davideochoa/kaablab/thesis/preliminares/12-resumen.md

# RESUMEN

El proyecto KaabLab busca adaptar, reentrenar y validar en condiciones reales un sistema de monitoreo inteligente de colmenas de *Melipona beecheii* basado en el Internet de las Cosas (IoT) e Inteligencia Artificial (IA). El pipeline de referencia (Chin-Canché et al., 2026a, 2026b) fue validado sobre datos de *Apis mellifera* en California y no ha sido adaptado a esta especie ni al clima tropical de Campeche; su módulo de visión computacional para detección de *Varroa destructor* no es transferible, pues Varroa no parasita a *Melipona beecheii*, y se excluye.

El sistema integra un módulo de análisis bioacústico —basado en Coeficientes Cepstrales en Escala de Frecuencias Mel (MFCC), vibración estructural y variables ambientales— y un módulo de conteo infrarrojo de tráfico en la piquera como proxy del forrajeo. Como contribución de diseño original se incorpora una arquitectura sensorial heterogénea con rangos complementarios: dos sensores de temperatura y humedad (interno primario y externo secundario), un micrófono para nivel acústico y estado general de la colonia, un acelerómetro para vibración del nido y un sensor infrarrojo de doble haz para conteo direccional. Esta arquitectura elimina modos de falla comunes, cubre la alta humedad relativa (>85% HR) donde el sensor externo se degrada, habilita el contraste diagnóstico interno-externo propio de una especie termoconformadora y captura las vibraciones estructurales mediante las cuales otros meliponinos expresan comportamiento defensivo (no documentado en *Melipona beecheii*), no registrables directamente con un micrófono (vibración de sustrato).

Esta tesis cierra tres brechas del trabajo previo: ausencia de datos propios de *Melipona beecheii*, falta de regionalización al clima tropical y ausencia de preprocesamiento de señal documentado antes de la extracción de características. Construye el primer dataset multimodal documentado de la especie y caracteriza cinco brechas bibliográficas en sus parámetros de medición (sección 1.1.5).

**Palabras clave: **meliponicultura maya, *Melipona beecheii*, monitoreo inteligente de colmenas, arquitectura sensorial heterogénea, redundancia sensorial, preprocesamiento de señal, fusión sensorial ponderada, bioacústica, vibración estructural, conteo infrarrojo de tráfico, IoT, XGBoost.
