davideochoa/kaablab/thesis/referencias.md

# Referencias

Formato APA. Este archivo es la fuente de trabajo versionada; la conversión a `.bib` (BibTeX) para gestión de citas queda pendiente (ver `docs/REVISION_2026-09.md`).

Chin-Canché, G. A. (2026). *GuillermoChin/kaablab-bee-congress-2026-figures: KAABLAB Bee Congress 2025: Figure reproduction package* (Versión v1.0.0) [Software]. Zenodo. https://doi.org/10.5281/zenodo.19685877

Chin-Canché, G. A., Ruíz-Canul, K., Grajales-Rodríguez, A. A., Guerrero-Mota, R. A., Noh-Valdéz, J. A., & Euan-Cupul, F. I. (2026a). KAABLAB: Sistema AIoT para el monitoreo y detección temprana de anomalías en colonias de abejas [Manuscrito inédito]. Instituto Tecnológico Superior de Calkiní.

Chin-Canché, G. A., Ruíz-Canul, K., Grajales-Rodríguez, A. A., Guerrero-Mota, R. A., Noh-Valdéz, J. A., & Euan-Cupul, F. I. (2026b). Kaablab: Sistema AIOT para el monitoreo y detección temprana de anomalías en colonias de *Apis mellifera*. En II Congreso sobre Abejas, Biodiversidad y Soberanía Alimentaria. *Ciencia y Tecnología ITESCAM-Calkiní, 5*(S4), 20. ISSN 2992-7692.

Cruz-López, L., Malo, E. A., Rojas, J. C., & Morgan, E. D. (2005). Chemical composition and stimulatory olfactory response of the mandibular gland secretion in *Melipona beecheii*. *Journal of Chemical Ecology, 31*(6), 1257-1268.

dos Santos, F. J., Bomfim, I. G. A., Cavalcante, M. C., Coelho, A. A. da P., & Gomes, D. G. (2025). Intranidal vibrational sensing mechanisms in stingless bees: an exploratory study. *Engenharia Agrícola, 45*(especial 2, ConBAP 2024), e20250069. https://doi.org/10.1590/1809-4430-Eng.Agric.v45nespe220250069/2025

Hrncir, M., Jarau, S., Zucchi, R., & Barth, F. G. (2000). Recruitment behavior in stingless bees, *Melipona scutellaris* and *M. quadrifasciata*. II. Possible mechanisms of communication. *Apidologie, 31*(1), 93–113. https://doi.org/10.1051/apido:2000109

Hrncir, M., Barth, F. G., & Tautz, J. (2006). Vibratory and airborne-sound signals in bee communication (Hymenoptera). In S. Drosopoulos & M. F. Claridge (Eds.), *Insect sounds and communication: Physiology, behaviour, ecology and evolution* (pp. 421–436). CRC Press.

Hrncir, M., Gravel, A.-I., Schorkopf, D. L. P., Schmidt, V. M., Zucchi, R., & Barth, F. G. (2008). Thoracic vibrations in stingless bees (*Melipona seminigra*): Resonances of the thorax influence vibrations associated with flight but not those associated with sound production. *Journal of Experimental Biology, 211*(5), 678–685. https://doi.org/10.1242/jeb.013920

Justino, A. R., & Hartfelder, K. (2024). A versatile recording device for the analysis of continuous daily external activity in colonies of highly eusocial bees. *Journal of Comparative Physiology A, 210*(6), 885-900. https://doi.org/10.1007/s00359-024-01709-2

Macías-Macías, J. O., Quezada-Euán, J. J. G., Contreras-Escareño, F., Tapia-González, J. M., Moo-Valle, H., & Ayala, R. (2011). Comparative temperature tolerance in stingless bee species from tropical highlands and lowlands of Mexico and implications for their conservation (Hymenoptera: Apidae: Meliponini). *Apidologie, 42*, 679–689. https://doi.org/10.1007/s13592-011-0074-0

Medina-Medina, L. A., Hart, A. G., & Ratnieks, F. L. W. (2014). Waste management in the stingless bee *Melipona beecheii* Bennett (Hymenoptera: Apidae). *Sociobiology, 61*(4), 435-440. https://doi.org/10.13102/sociobiology.v61i4.435-440

Moo-Valle, H., Quezada-Euán, J. J. G., Navarro, J., & Rodríguez-Carvajal, L. A. (2000). Patterns of intranidal temperature fluctuation for *Melipona beecheii* colonies in natural nesting cavities. *Journal of Apicultural Research, 39*, 3–7.

Pat Fernández, L. A., Anguebes Franceschi, F., Pat Fernández, J. M., Hernández Bahena, P., & Ramos Reyes, R. (2018). Condición y perspectivas de la meliponicultura en comunidades mayas de la reserva de la biósfera Los Petenes, Campeche, México. *Estudios de Cultura Maya, 52*, 227-254. https://doi.org/10.19130/iifl.ecm.2018.52.939

Quezada-Euán, J. J. G. (2018). *Stingless Bees of Mexico: The Biology, Management and Conservation of an Ancient Heritage*. Springer.

Roubik, D. W. (2006). Stingless bee nesting biology. *Apidologie, 37*(2), 124–143. https://doi.org/10.1051/apido:2006026

Roubik, D. W., & Peralta, F. J. A. (1983). Thermodynamics in nests of two *Melipona* species in Brazil. *Acta Amazonica, 13*, 453–466.

Schurischuster, S., & Kampel, M. (2020). *VarroaDataset* [Data set]. Zenodo. https://doi.org/10.5281/zenodo.4085044

Suárez Carvajal, Y. Y. (2025). Estimación del impacto de variables internas y ambientales en la vitalidad de las colonias de Melipona eburnea en Colombia, generando alertas tempranas que permitan optimizar el manejo y mejorar su bienestar [Trabajo de grado de maestría, Universidad Tecnológica de Pereira]. Facultad de Ingeniería Mecánica, Pereira, Colombia.

Yang, A. (2022). *Beehive sounds* [Data set]. Kaggle. https://kaggle.com/datasets/annajyang/beehive-sounds

## Referencias ya citadas en el cuerpo de la tesis (no verificadas en esta revisión)

Las siguientes referencias ya son citadas en los capítulos existentes pero no fueron parte del alcance de esta revisión (PASO 7); se listan aquí para que la compilación final de la bibliografía las incluya:

- Cauich Kumul, R., Ruiz Ruiz, J. C., Ortíz Vázquez, E., & Segura Campos, M. R. (2015). Potencial antioxidante de la miel de *Melipona beecheii* y su relación con la salud: una revisión. *Nutrición Hospitalaria, 32*(4), 1432–1442. https://doi.org/10.3305/nh.2015.32.4.9312
- Ramírez-Miranda, I., Moguel-Ordóñez, Y., Acevedo-Fernández, J. J., & Betancur-Ancona, D. (2023). Calidad microbiológica y actividad antibacteriana de miel producida por Melipona beecheii en Yucatán, México. *Revista MVZ Córdoba, 28*(2), e3175. https://doi.org/10.21897/rmvz.3175
- Uthoff, C., Homsi, M. N., & von Bergen, M. (2023). Acoustic and vibration monitoring of honeybee colonies for beekeeping-relevant aspects of presence of queen bee and swarming. *Computers and Electronics in Agriculture, 205*, 107589. https://doi.org/10.1016/j.compag.2022.107589
- Villanueva-Gutiérrez, R., Roubik, D. W., Colli-Ucán, W., Güemez-Ricalde, F. J., & Buchmann, S. L. (2013). A critical view of colony losses in managed Mayan honey-making bees (Apidae: Meliponini) in the heart of Zona Maya. *Journal of the Kansas Entomological Society, 86*(4), 352–362. https://doi.org/10.2317/JKES130131.1
