davideochoa/kaablab/thesis/docs/FORMATO_TESIS.md

# Formato oficial de tesis — ITESCAM (Maestría en Ciencias de la Ingeniería / Inteligencia Artificial)

Fuente: Estructura_de_tesis_de_posgrado_Revisada.docx (plantilla institucional).

## Página

- Tamaño: carta (letter).
- Márgenes: 2.5 cm en los cuatro lados.
- Numeración de página: pie de página, alineada a la derecha, Arial 11 pt.
- Preliminares (desde el índice hasta la página anterior al resumen): numeración romana minúscula (i, ii, iii...).
- Cuerpo (desde la Introducción en adelante): numeración arábiga, iniciando en 1.

## Tipografía

- Cuerpo de texto: Arial 11 pt, interlineado 1.5, espaciado de párrafo: 12 pt antes / 0 pt después.
- Títulos de capítulo: Arial 12 pt, MAYÚSCULAS, negritas, alineados a la IZQUIERDA. Numeración con romanos (I, II, III, IV, V).
- Subtítulos de nivel 1 (dentro de un capítulo): Arial 11 pt, MAYÚSCULAS, negritas.
- Subtítulos de nivel 2 en adelante: Arial 11 pt, Mayúsculas y minúsculas, negritas.
- Secciones especiales del preliminar (RESUMEN, ABSTRACT, INTRODUCCIÓN, etc.): MAYÚSCULAS, negritas, CENTRADAS (distinto de los títulos de capítulo, que van a la izquierda).

## Estructura de capítulos (confirmada con el usuario)

- Capítulo I: Antecedentes, justificación, hipótesis, objetivos generales y específicos, y estrategia experimental (incluye el estado del arte / marco teórico, fusionado aquí, no como capítulo separado).
- Capítulo II: Materiales y Métodos.
- Capítulo III: Resultados y Discusiones.
- Capítulo IV: Recomendaciones.
- Capítulo V: Conclusiones.

Nota: la plantilla original omite por error la línea del Capítulo IV (salta de "Capítulo III" a "Capítulo V"); la estructura de 5 capítulos arriba fue confirmada explícitamente con el autor de la tesis como la interpretación correcta.

## Orden del cuerpo antes de la Introducción

1. Portada interior
2. Carta de liberación de tesis (CPI-FO-05-06)
3. Oficio de autorización del comité tutorial/claustro doctoral
4. Carta de reconocimiento del director(a) y codirector(a)
5. Declaración de propiedad intelectual
6. Carta de cesión de derechos (requerida por los Lineamientos TecNM 2023, 3.9; no aparece en la plantilla institucional; incluir con firma autógrafa)
7. Oficio de liberación (análisis anti-plagio)
8. Agradecimientos (si aplica beca)
9. Índice completo
10. Listado de abreviaturas (si aplica)
11. Índice de Figuras (solo títulos)
12. Índice de Tablas (solo títulos)
13. Resumen (español) — máximo 1 cuartilla
14. Abstract (inglés) — máximo 1 cuartilla
15. Introducción — máximo 2 cuartillas

## Tablas y figuras

- Formato: "Tabla 1.1" / "Figura 1.1" en negritas, SIN punto después del número, numeración correlativa por capítulo (el primer número es el del capítulo).
- Fuente: Arial 10 pt, mayúsculas y minúsculas.
- El pie de figura/tabla va en el renglón inmediato siguiente a la figura/tabla.
- Tamaño: no debe rebasar los márgenes del texto.

## Citas y bibliografía (formato APA)

- Un autor: (Apellido, Año).
- Dos autores: (Apellido1 y Apellido2, Año).
- Más de dos autores: (Apellido et al., Año).
- Múltiples citas en un mismo paréntesis: ordenar de la más reciente a la más antigua, separadas por punto y coma. Ejemplo: (López y Pérez, 2010; Smith, 2009; Wilmer et al., 1998).
- Listado bibliográfico: orden alfabético y cronológico, sangría francesa de 1.5 cm, interlineado 1.5, espaciado 12 pt antes / 0 pt después, formato APA.
- Se incluyen todas las referencias de todos los capítulos en una sola bibliografía al final.

## Nombre científico de la especie (PROVISIONAL — pendiente de confirmar con asesor)

El asesor indicó que el nombre científico de la especie lleva un formato especial, pero la recomendación exacta no quedó registrada. Mientras se confirma, se aplica la convención taxonómica estándar:

- Nombre científico completo (género + especie) siempre en cursivas: *Melipona beecheii*.
- Primera mención en cada capítulo: nombre completo con autor taxonómico — *Melipona beecheii* Bennett, 1831.
- Menciones subsecuentes en el mismo capítulo: género abreviado, en cursivas — *M. beecheii*.
- Nunca abreviar en: primera mención de una sección nueva, títulos de tabla/figura, resumen o abstract.

## Pendiente de verificar con el asesor

- Confirmar si la fusión del Estado del Arte dentro del Capítulo I (en vez de capítulo separado) es aceptable, dado que este proyecto tiene suficiente revisión de literatura propia para justificar un capítulo dedicado.
- Confirmar el formato exacto solicitado por el asesor para el nombre científico de la especie (la convención de arriba es una suposición de trabajo, no la recomendación real).
