davideochoa/kaablab/thesis/preliminares/00-portada.md

**INSTITUTO TECNOLÓGICO SUPERIOR DE CALKINÍ**

**SUBDIRECCIÓN ACADÉMICA DE INVESTIGACIÓN E INNOVACIÓN**

**MAESTRÍA EN INTELIGENCIA ARTIFICIAL**

**KAABLAB: INNOVACIÓN PARA LA PROTECCIÓN DE LAS ABEJAS MAYAS MEDIANTE UN SISTEMA INTELIGENTE DE MONITOREO DE COLMENAS DE MELIPONA BEECHEII BASADO EN IoT E INTELIGENCIA ARTIFICIAL**

**TESIS**

Que para obtener el título de:

**MAESTRO EN INTELIGENCIA ARTIFICIAL**

Presenta:

**DAVID ENRIQUE OCHOA DIAZ**

Comité tutorial:

Director: Dra. Marlene Méndez Moreno

Codirector: Dr. Rogelio Alfredo Flores Haas

Asesor interno: Mtro. Daniel Bolivar Moreno

Asesor externo: Dr. Henry Jesus Loeza Concha - Colegio de Posgraduado Campeche

Calkiní, Campeche, México — 2026
