davideochoa/kaablab/thesis/preliminares/04-declaracion-propiedad-intelectual.md

# DECLARACIÓN DE PROPIEDAD INTELECTUAL

Yo, David Enrique Ochoa Diaz, estudiante del programa de Maestría en Inteligencia Artificial del Instituto Tecnológico Superior de Calkiní en el Estado de Campeche (ITESCAM), del Tecnológico Nacional de México (TecNM), declaro que la tesis titulada “KAABLAB: INNOVACIÓN PARA LA PROTECCIÓN DE LAS ABEJAS MAYAS MEDIANTE UN SISTEMA INTELIGENTE DE MONITOREO DE COLMENAS DE *MELIPONA BEECHEII* BASADO EN IoT E INTELIGENCIA ARTIFICIAL” es una obra original, resultado de mi trabajo de investigación, desarrollada bajo la dirección de la Dra. Marlene Méndez Moreno.

Declaro que:

1. Las fuentes, ideas, datos, figuras y resultados de terceros utilizados están debidamente citados y referenciados.
2. El trabajo no ha sido presentado total ni parcialmente para obtener otro grado académico en esta u otra institución.
3. Los datos experimentales, el código fuente y los resultados fueron generados por mí en el marco del proyecto KaabLab y son fieles a los obtenidos durante la investigación.
4. La protección de la propiedad intelectual (derechos de autor y propiedad industrial) se sujeta a la Ley de Ciencia y Tecnología, a la normativa aplicable vigente, a los Lineamientos para la Operación de los Estudios de Posgrado del TecNM (2023) y a las directrices de la Secretaría de Extensión y Vinculación del TecNM. Los trámites de propiedad industrial (patentes, modelos de utilidad, diseños industriales) corresponden al IMPI y los de derechos de autor, al INDAUTOR.
5. Los artículos, libros o memorias derivados de este trabajo se regirán por el apartado 6.1 de los Lineamientos: si los publica una editorial comercial, los derechos se ceden a ésta; si los publica el TecNM, la titularidad corresponde en su totalidad al TecNM.
6. Autorizo el depósito de la tesis en el repositorio institucional de acceso abierto, en los términos de la Ley Federal del Derecho de Autor, salvo que exista acuerdo de confidencialidad o proceso de registro de propiedad intelectual en curso. Condición de acceso:

   ☐ Sin restricción ☐ Restringido por confidencialidad o registro de propiedad intelectual

7. Asumo la responsabilidad por cualquier reclamación de terceros derivada de la violación de derechos de propiedad intelectual relacionada con este trabajo.

Calkiní, Campeche, a 16 de octubre de 2026

David Enrique Ochoa Diaz

10383
