davideochoa/kaablab/thesis/preliminares/05-carta-cesion-derechos.md

# CARTA DE CESIÓN DE DERECHOS

Calkiní, Campeche, a 16 de octubre de 2026

Tecnológico Nacional de México

Instituto Tecnológico Superior de Calkiní en el Estado de Campeche (ITESCAM)

División de Estudios de Posgrado e Investigación (DEPI)

P R E S E N T E

Yo, David Enrique Ochoa Diaz, con matrícula 10383, estudiante del programa de Maestría en Inteligencia Artificial, autor de la tesis titulada “KAABLAB: INNOVACIÓN PARA LA PROTECCIÓN DE LAS ABEJAS MAYAS MEDIANTE UN SISTEMA INTELIGENTE DE MONITOREO DE COLMENAS DE *MELIPONA BEECHEII* BASADO EN IoT E INTELIGENCIA ARTIFICIAL”, desarrollada bajo la dirección de la Dra. Marlene Méndez Moreno en el marco del proyecto KaabLab, con fundamento en los Lineamientos para la Operación de los Estudios de Posgrado del TecNM (2023), secciones 3.9 y 6, manifiesto lo siguiente:

1. Soy autor de la tesis y de los productos académicos derivados de ella, y cuento con la facultad de ceder los derechos que aquí se indican.
2. Cedo al Tecnológico Nacional de México los derechos patrimoniales de la tesis y de los productos académicos derivados susceptibles de protección (registro de software, patente, modelo de utilidad, diseño industrial u otro), para que el TecNM realice los trámites de protección ante el INDAUTOR o el IMPI, según corresponda.
3. Autorizo el depósito, la consulta y la difusión de la tesis en el Repositorio Institucional, en acceso abierto conforme a la Ley Federal del Derecho de Autor. Condición de acceso:

   ☐ Sin restricción ☐ Restringido por acuerdo de confidencialidad o proceso de registro de propiedad intelectual en curso

4. Los derechos morales de la obra permanecen conmigo. Se reconocerá mi autoría, junto con la de la directora de tesis y, en su caso, la de los miembros del Comité Tutorial según su contribución, en los productos académicos derivados.
5. Cualquier uso comercial de los productos generados requerirá un convenio entre el TecNM y las partes interesadas, revisado por la dirección correspondiente.
6. Los derechos de propiedad industrial de los productos derivados de proyectos financiados por empresas, organismos o instituciones externas se regirán por los convenios específicos firmados al respecto.
7. Esta cesión se firma de manera libre y voluntaria, y se incluirá en el archivo electrónico de la tesis.

ATENTAMENTE

David Enrique Ochoa Diaz

Firma autógrafa

10383
