davideochoa/kaablab/thesis/preliminares/06-oficio-antiplagio.md

<!-- DOCUMENTO OFICIAL PENDIENTE
     Este archivo representa un documento firmado por la institución
     (oficio, carta o declaración). No se redacta como texto libre.
     Sustituir por el escaneo o PDF oficial correspondiente antes
     de compilar la tesis final.
     Formato de referencia: [nombre del formato oficial, ej. CPI-FO-05-06]
-->
