davideochoa/kaablab/thesis/preliminares/08-indice.md

# ÍNDICE

- Portada interior
- CARTA DE LIBERACIÓN DE TESIS
- OFICIO DE AUTORIZACIÓN DEL COMITÉ TUTORIAL/CLAUSTRO DOCTORAL
- CARTA DE RECONOCIMIENTO DEL DIRECTOR(A) Y CODIRECTOR(A) DE TESIS
- DECLARACIÓN DE PROPIEDAD INTELECTUAL
- CARTA DE CESIÓN DE DERECHOS
- OFICIO DE LIBERACIÓN DE ANÁLISIS ANTI-PLAGIO
- AGRADECIMIENTOS (pendiente de contenido)
- ÍNDICE
- ABREVIATURAS
- ÍNDICE DE FIGURAS
- ÍNDICE DE TABLAS
- RESUMEN
- ABSTRACT
- INTRODUCCIÓN

- CAPÍTULO I. ANTECEDENTES, PLANTEAMIENTO Y OBJETIVOS DE LA INVESTIGACIÓN
  - 1.1 Antecedentes
    - 1.1.1 La meliponicultura maya y *Melipona beecheii*
    - 1.1.2 Limitaciones del artículo de referencia
    - 1.1.3 Hallazgos metodológicos clave del artículo de referencia
    - 1.1.4 Amenazas bióticas en colmenas de *M. beecheii*
    - 1.1.5 Brechas bibliográficas en los cinco parámetros de medición
  - 1.2 Planteamiento del problema
  - 1.3 Pregunta de investigación
  - 1.4 Hipótesis
  - 1.5 Objetivos
    - 1.5.1 Objetivo general
    - 1.5.2 Objetivos específicos
  - 1.6 Justificación
    - 1.6.1 Conveniencia, relevancia social e implicaciones prácticas
  - 1.7 Alcances y limitaciones
  - 1.8 Estrategia experimental
  - 1.9 Planeación: recursos, cronograma y presupuesto

- CAPÍTULO II. MATERIALES Y MÉTODOS
  - 2.1 Enfoque y diseño de investigación
  - 2.2 Arquitectura sensorial heterogénea con rangos complementarios
    - 2.2.1 Fundamento físico de la humedad: SHT31 interno primario y DHT22 externo secundario
    - 2.2.2 Fundamento físico del INMP441 y el MPU6500 como sensores complementarios
    - 2.2.3 Sensor IR doble haz — conteo de tráfico en piquera
    - 2.2.4 Fusión sensorial ponderada por confianza
  - 2.3 Instrumentación y flujo de adquisición de datos (IoT)
    - 2.3.1 Conexión de los sensores
    - 2.3.2 Disposición física en la colmena
    - 2.3.3 Flujo del dato: de la captura al dataset
  - 2.4 Protocolo de preprocesamiento de señal
    - 2.4.1 Filtro de media móvil sobre variables ambientales
    - 2.4.2 Pre-énfasis sobre la señal de audio
    - 2.4.3 Umbral de energía RMS para descarte de segmentos silenciosos
    - 2.4.4 Normalización Z-score del vector de características
    - 2.4.5 Conversión de humedad relativa a humedad absoluta
  - 2.5 Arquitectura del sistema KaabLab completo
  - 2.6 Consideraciones de interferencia del hardware IoT en *M. beecheii*
  - 2.7 Pipeline de procesamiento y evaluación (IA)
  - 2.8 Justificación técnica de las decisiones de diseño de IA
    - 2.8.1 Número de coeficientes MFCC (n = 13)
    - 2.8.2 Validación cruzada de 3 pliegues
    - 2.8.3 XGBoost y Gradient Boosting
  - 2.9 Protocolo de construcción del dataset
    - 2.9.1 Recolección de datos bioacústicos, de vibración y ambientales
    - 2.9.2 Recolección de datos de conteo IR en piquera
    - 2.9.3 Manejo del desbalance de clases
    - 2.9.4 Partición y almacenamiento del dataset
  - 2.10 Métricas de evaluación

- CAPÍTULO III. RESULTADOS Y DISCUSIONES
  - 3.1 Estado actual del proyecto: evidencia técnica disponible
    - 3.1.1 Baseline validado: pipeline completo para *Apis mellifera*
    - 3.1.2 Repositorios públicos con código y datos
    - 3.1.3 Análisis de transferibilidad del pipeline
    - 3.1.4 Problemas técnicos identificados y estrategias de mitigación
    - 3.1.5 Validación de arquitectura con datos sintéticos
  - 3.2 Contribuciones originales esperadas
  - 3.3 Discusión

- CAPÍTULO IV. RECOMENDACIONES
  - 4.1 Recomendaciones

- CAPÍTULO V. CONCLUSIONES
  - 5.1 Conclusiones

- BIBLIOGRAFÍA
