davideochoa/kaablab/thesis/preliminares/10-indice-figuras.md

# ÍNDICE DE FIGURAS

Figura 2.1 Conexión de los sensores al nodo de borde .......... [pendiente]

Figura 2.2 Disposición física de la instrumentación en la colmena .......... [pendiente]

Figura 2.3 Flujo del dato desde la captura hasta el dataset .......... [pendiente]

Figura 2.4 Pipeline de procesamiento y evaluación de IA .......... [pendiente]

<!-- Generado por indexado manual de las líneas "**Figura X.Y **..." de los
     5 capítulos (Capítulos I, III, IV y V no contienen figuras). El número
     de página se completa al ensamblar el documento final en Word. -->
