davideochoa/kaablab/thesis/preliminares/14-introduccion.md

# INTRODUCCIÓN

La meliponicultura maya —el cultivo de *Melipona beecheii* Bennett, 1831, la abeja señora o xunan kab— es una práctica biocultural de más de dos milenios en la Península de Yucatán. Sus colonias enfrentan declive acelerado por pérdida de hábitat, agroquímicos y ausencia de herramientas tecnológicas adaptadas. El Laboratorio de Ambientes Inteligentes del ITESCAM publicó KAABLAB (Chin-Canché et al., 2026b), un sistema AIoT de monitoreo inteligente validado sobre datos de *Apis mellifera*. Esta tesis constituye la etapa de adaptación del sistema a *M. beecheii*, incorporando además tres mejoras metodológicas que el artículo de referencia no contempló: regionalización al clima tropical de Campeche, preprocesamiento formal de señal de sensores, y arquitectura sensorial heterogénea con rangos complementarios.
