davideochoa/kaablab/thesis/preliminares/09-indice-figuras.md

# ÍNDICE DE FIGURAS

<!-- Se genera automáticamente al compilar el documento final,
     listando cada figura/tabla en formato "Figura X.Y" o "Tabla X.Y"
     donde X es el número de capítulo, sin punto después del número -->
