davideochoa/kaablab/(commit log)

2026-09-07 Estructura inicial del repo KaabLab (licencia pendiente de definición institucional)
    Claude-Session: https://claude.ai/code/session_01FNpcWP5ikdc8tAX3tFVUMi
2026-09-13 add sensor-IR-doble-haz
2026-09-14 add temperatura
2026-09-19 add ESP32
2026-10-29 Soporte dual Arduino/Raspberry: sketches por carpeta, raspberry/ rescatado, firmware/ eliminad
